suikan4github/Akashi-11/docs/Akashi-11.pdf

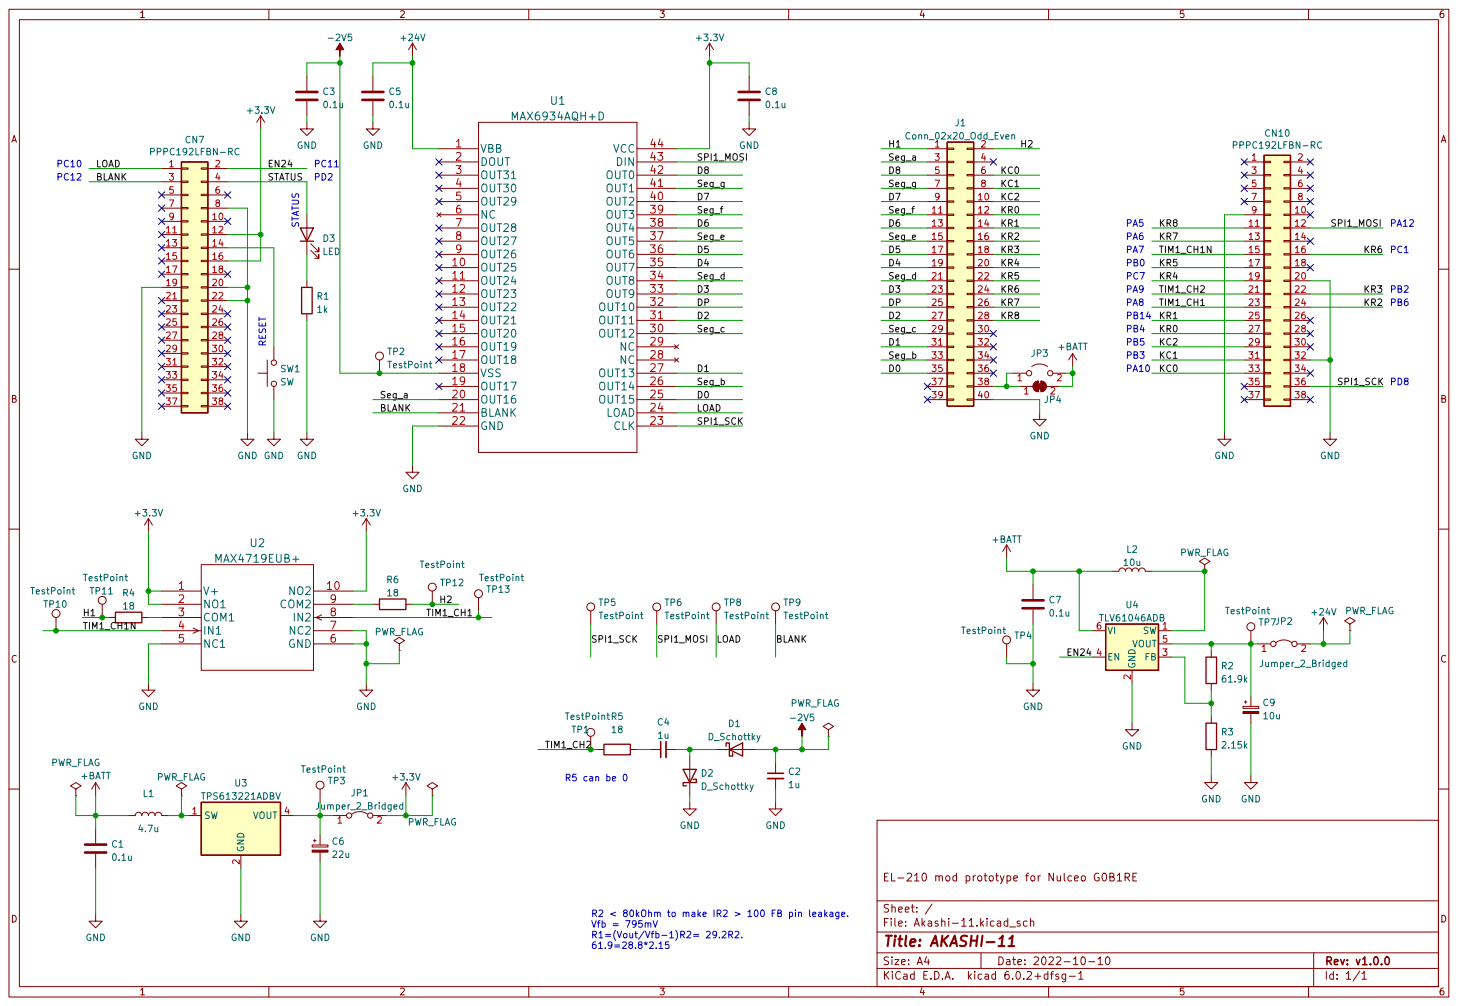
[picture p2: page 1]

2 FB 3 EN 4 VOUT 5 VI 6 U4 TLV61046ADB GND GND

File: Akashi-11.kicad_sch Sheet: / EL-210 mod prototype for Nulceo G0B1RE
