suikan4github/Akashi-11/Akashi-11.kicad_pcb

## KiCad design Akashi-11.kicad_pcb (2023-01-11)

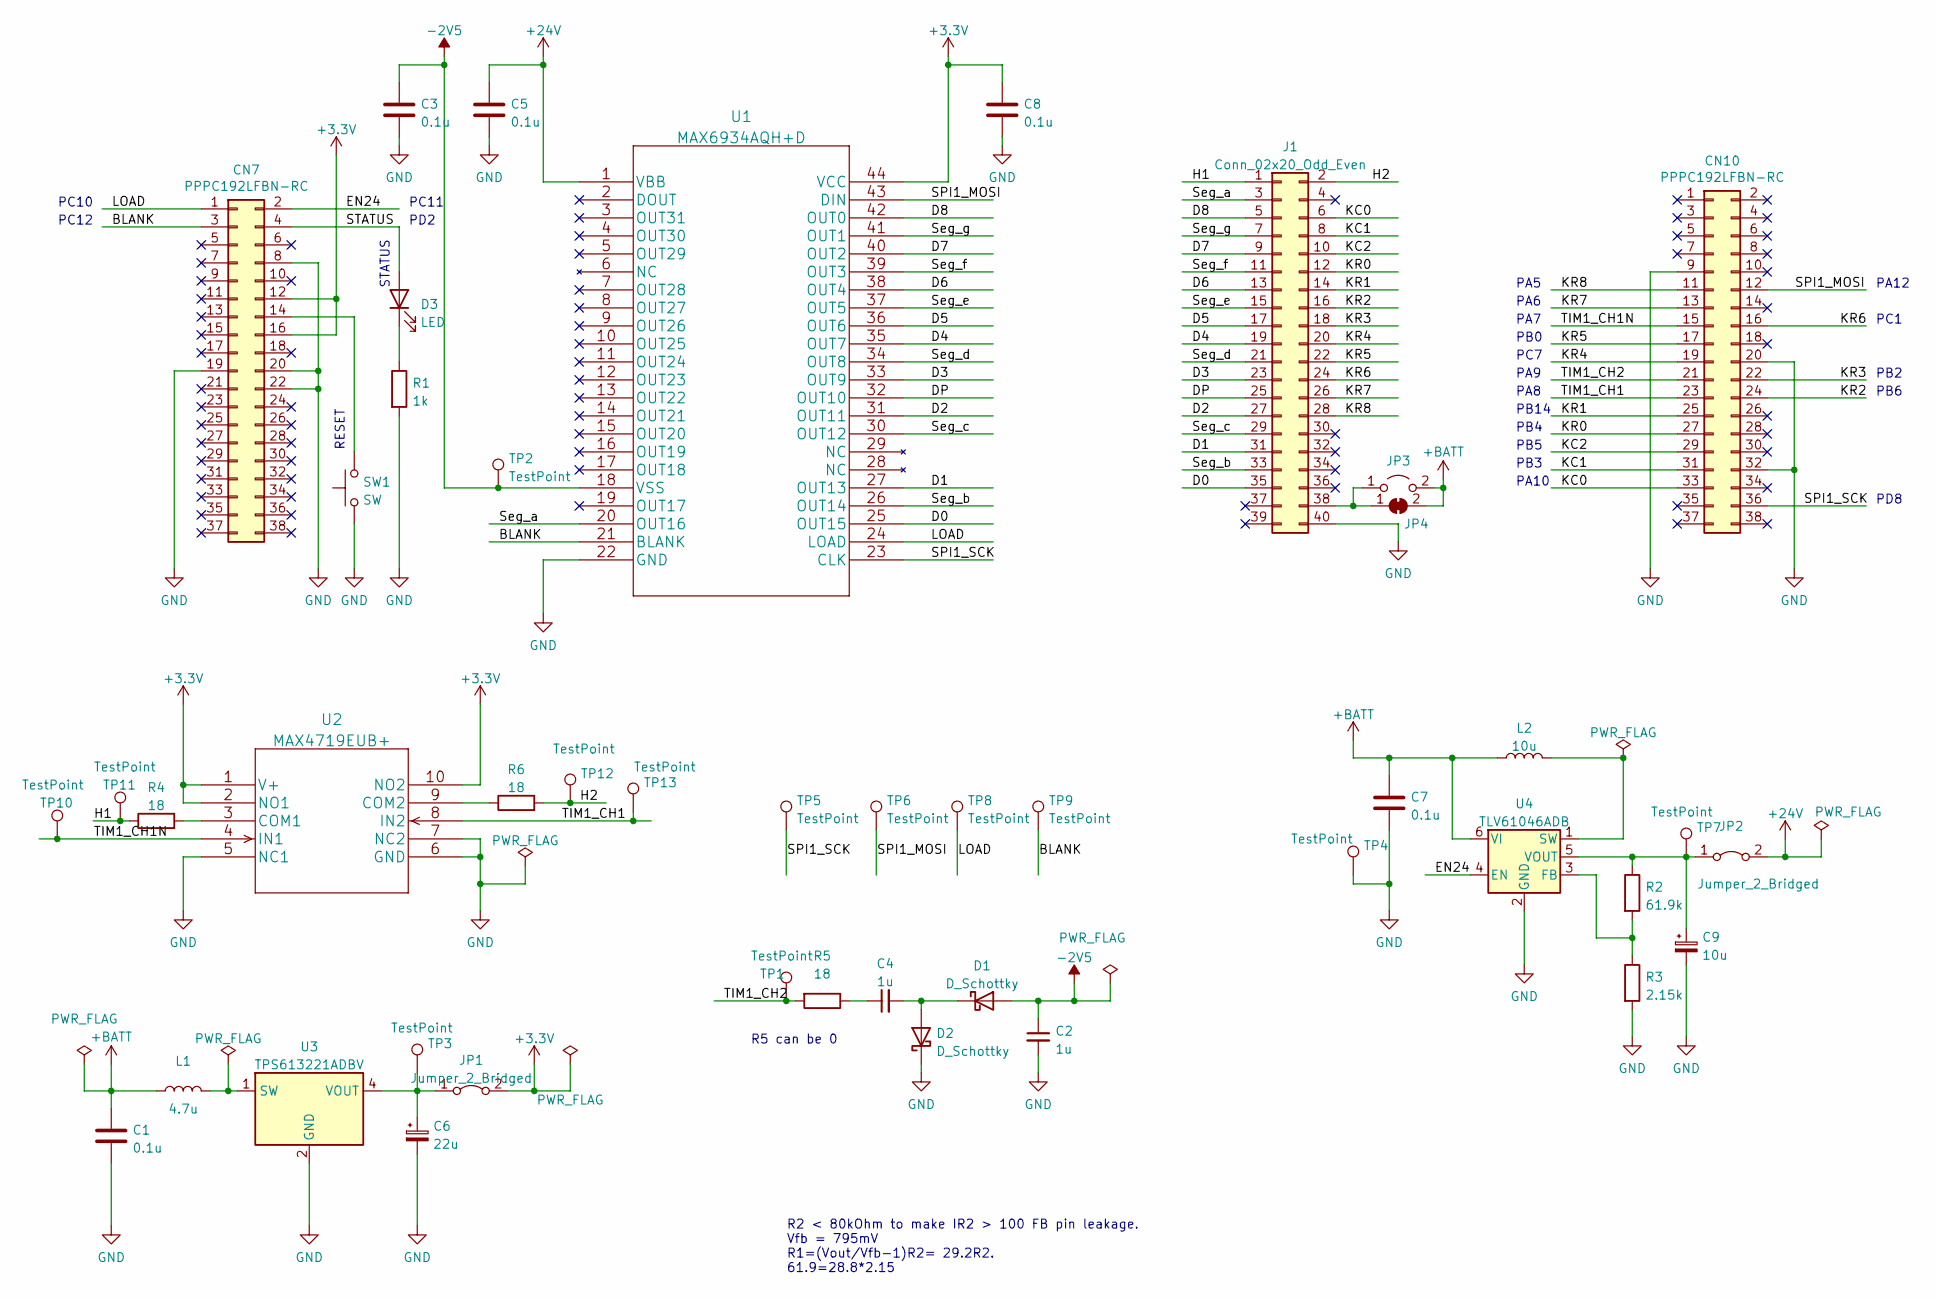
[picture p3: schematic Akashi-11.kicad_sch]

Parts:
C1, C3, C5, C7, C8: 0.1u; C_0603_1608Metric_Pad1.08x0.95mm_HandSolder
C2, C4: 1u; C_0603_1608Metric_Pad1.08x0.95mm_HandSolder
C6: 22u; CP_Elec_6.3x3
C9: 10u; CP_Elec_4x3.9
CN7, CN10: PPPC192LFBN-RC; PinSocket_2x19_P2.54mm_Vertical
D1, D2: D_Schottky; C_0603_1608Metric_Pad1.08x0.95mm_HandSolder
D3: LED; LED_D4.0mm
J1: Conn_02x20_Odd_Even; PinHeader_2x20_P2.54mm_Vertical
JP1, JP2: Jumper_2_Bridged; SolderJumper-2_P1.3mm_Bridged_RoundedPad1.0x1.5mm
JP3: Jumper_2_Open; PinHeader_1x02_P2.54mm_Vertical
JP4: SolderJumper_2_Bridged; SolderJumper-2_P1.3mm_Bridged_RoundedPad1.0x1.5mm
L1: 4.7u; LQH5BPN100M38L
L2: 10u; LQH5BPN100M38L
R1: 1k; C_0603_1608Metric_Pad1.08x0.95mm_HandSolder
R2: 61.9k; C_0603_1608Metric_Pad1.08x0.95mm_HandSolder
R3: 2.15k; C_0603_1608Metric_Pad1.08x0.95mm_HandSolder
R4, R5, R6: 18; C_0603_1608Metric_Pad1.08x0.95mm_HandSolder
SW1: SW; SW_TH_Tactile_Omron_B3F-10xx
TP1, TP2, TP3, TP4, TP5, TP6, TP7, TP8, TP9, TP10, TP11, TP12, TP13: TestPoint; TestPoint_Loop_D1.80mm_Drill1.0mm_Beaded
U1: MAX6934AQH+D; PLCC-44_THT-Socket
U2: MAX4719EUB+; MAX4719EUB
U3: TPS613221ADBV; SOT-23-5
U4: TLV61046ADB; SOT-23-6

Connections:
+3V3: C8.1, CN7.12, CN7.16, JP1.2 (B), U1.44 (VCC), U2.1 (V+), U2.2 (NO1), U2.10 (NO2)
+24V: C5.1, JP2.2 (B), U1.1 (VBB)
+BATT: C1.1, C7.1, JP3.2 (B), JP4.2 (B), L1.1, L2.1, U4.6 (VI)
-2V5: C2.1, C3.1, D1.2 (A), TP2.1, U1.18 (VSS)
/BLANK: CN7.3, TP9.1, U1.21 (BLANK)
/D0: J1.35, U1.25 (OUT15)
/D1: J1.31, U1.27 (OUT13)
/D2: J1.27, U1.31 (OUT11)
/D3: J1.23, U1.33 (OUT9)
/D4: J1.19, U1.35 (OUT7)
/D5: J1.17, U1.36 (OUT6)
/D6: J1.13, U1.38 (OUT4)
/D7: J1.9, U1.40 (OUT2)
/D8: J1.5, U1.42 (OUT0)
/DP: J1.25, U1.32 (OUT10)
/EN24: CN7.2, U4.4 (EN)
/H1: J1.1, R4.1, TP11.1
/H2: J1.2, R6.2, TP12.1
/KC0: CN10.33, J1.6
/KC1: CN10.31, J1.8
/KC2: CN10.29, J1.10
/KR0: CN10.27, J1.12
/KR1: CN10.25, J1.14
/KR2: CN10.24, J1.16
/KR3: CN10.22, J1.18
/KR4: CN10.19, J1.20
/KR5: CN10.17, J1.22
/KR6: CN10.16, J1.24
/KR7: CN10.13, J1.26
/KR8: CN10.11, J1.28
/LOAD: CN7.1, TP8.1, U1.24 (LOAD)
/SPI1_MOSI: CN10.12, TP6.1, U1.43 (DIN)
/SPI1_SCK: CN10.36, TP5.1, U1.23 (CLK)
/STATUS: CN7.4, D3.2 (A)
/Seg_a: J1.3, U1.20 (OUT16)
/Seg_b: J1.33, U1.26 (OUT14)
/Seg_c: J1.29, U1.30 (OUT12)
/Seg_d: J1.21, U1.34 (OUT8)
/Seg_e: J1.15, U1.37 (OUT5)
/Seg_f: J1.11, U1.39 (OUT3)
/Seg_g: J1.7, U1.41 (OUT1)
/TIM1_CH1: CN10.23, TP13.1, U2.8 (IN2)
/TIM1_CH1N: CN10.15, TP10.1, U2.4 (IN1)
/TIM1_CH2: CN10.21, R5.2, TP1.1
GND: C1.2, C2.2, C3.2, C5.2, C6.2, C7.2, C8.2, C9.2, CN7.8, CN7.19, CN7.20, CN7.22, CN10.9, CN10.20, CN10.32, D2.1 (K), J1.40, R1.2, R3.2, SW1.1 (A), SW1.2 (A), TP4.1, U1.22 (GND), U2.5 (NC1), U2.6 (GND), U2.7 (NC2), U3.2 (GND), U4.2 (GND)
unnamed: C4.1, R5.1
unnamed: C4.2, D1.1 (K), D2.2 (A)
unnamed: C6.1, JP1.1 (A), TP3.1, U3.4 (VOUT)
unnamed: C9.1, JP2.1 (A), R2.1, TP7.1, U4.5 (VOUT)
unnamed: CN7.14, SW1.3 (B), SW1.4 (B)
unnamed: D3.1 (K), R1.1
unnamed: J1.38, JP3.1 (A), JP4.1 (A)
unnamed: L1.2, U3.1 (SW)
unnamed: L2.2, U4.1 (SW)
unnamed: R2.2, R3.1, U4.3 (FB)
unnamed: R4.2, U2.3 (COM1)
unnamed: R6.1, U2.9 (COM2)

Notes on the sheet:
PB6
PD8
RESET
PA9
STATUS
R5 can be 0
PC1
PB2
R2 < 80kOhm to make IR2 > 100 FB pin leakage. Vfb = 795mV R1=(Vout/Vfb-1)R2= 29.2R2. 61.9=28.8*2.15
PC10
PA5
PB4
PB5
PB14
PA6
PB3
PC11
PC12
PB0
PD2
PA10
PA8
PC7
PA12
PA7

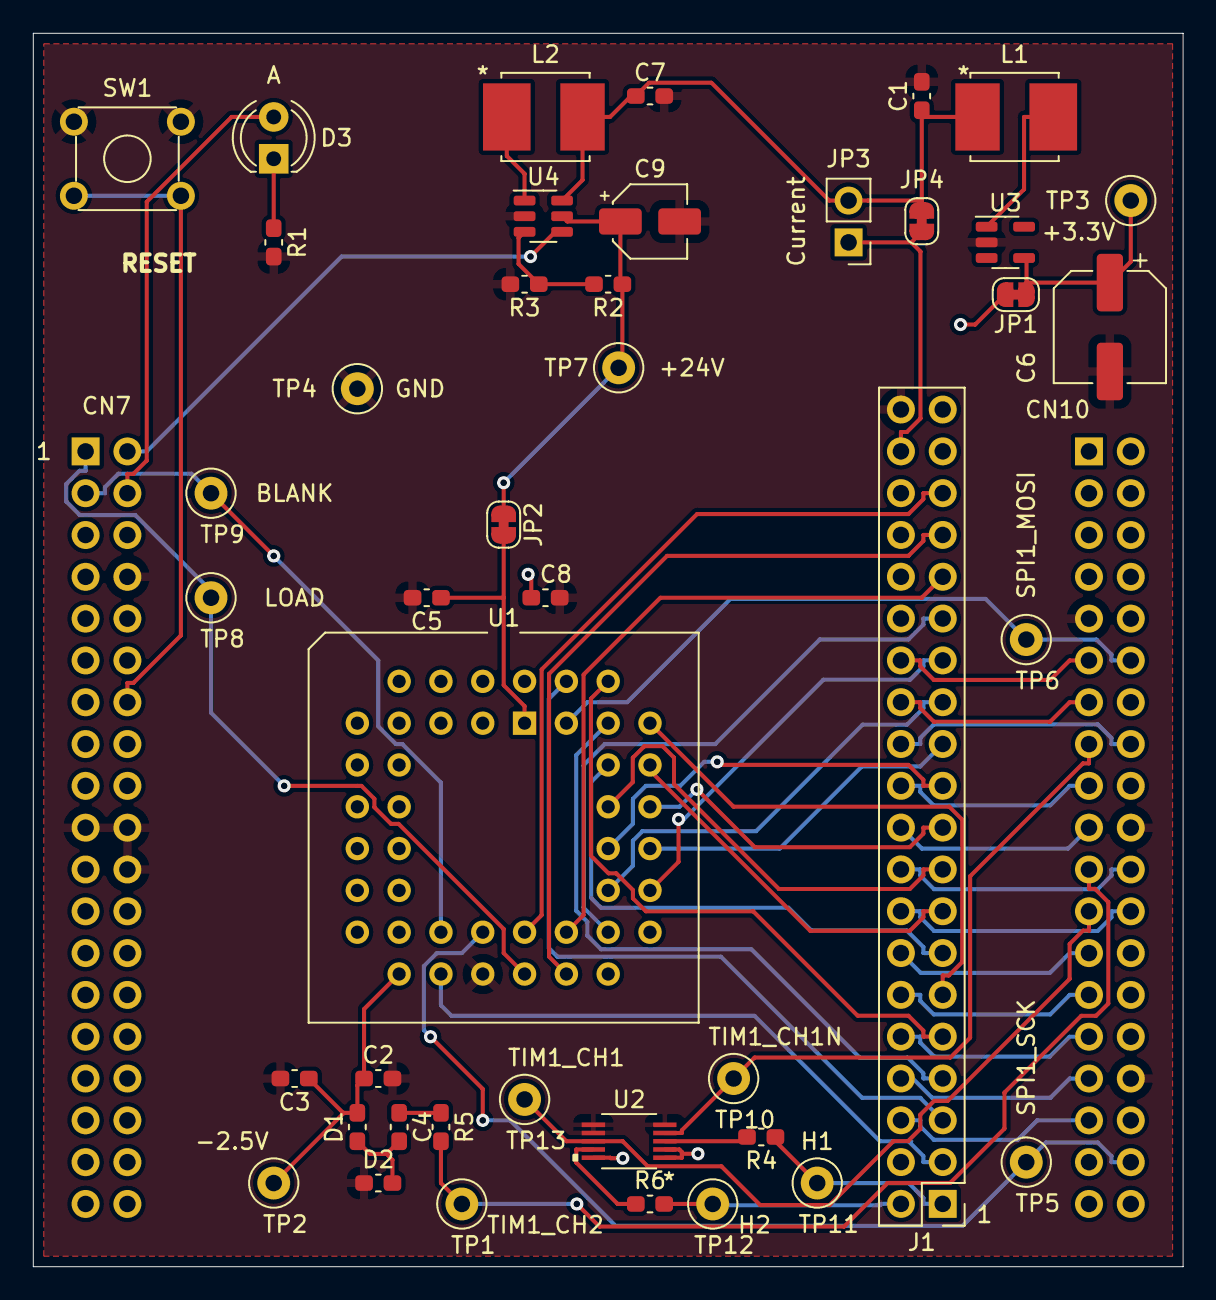
[picture p4: board Akashi-11.kicad_pcb from above]

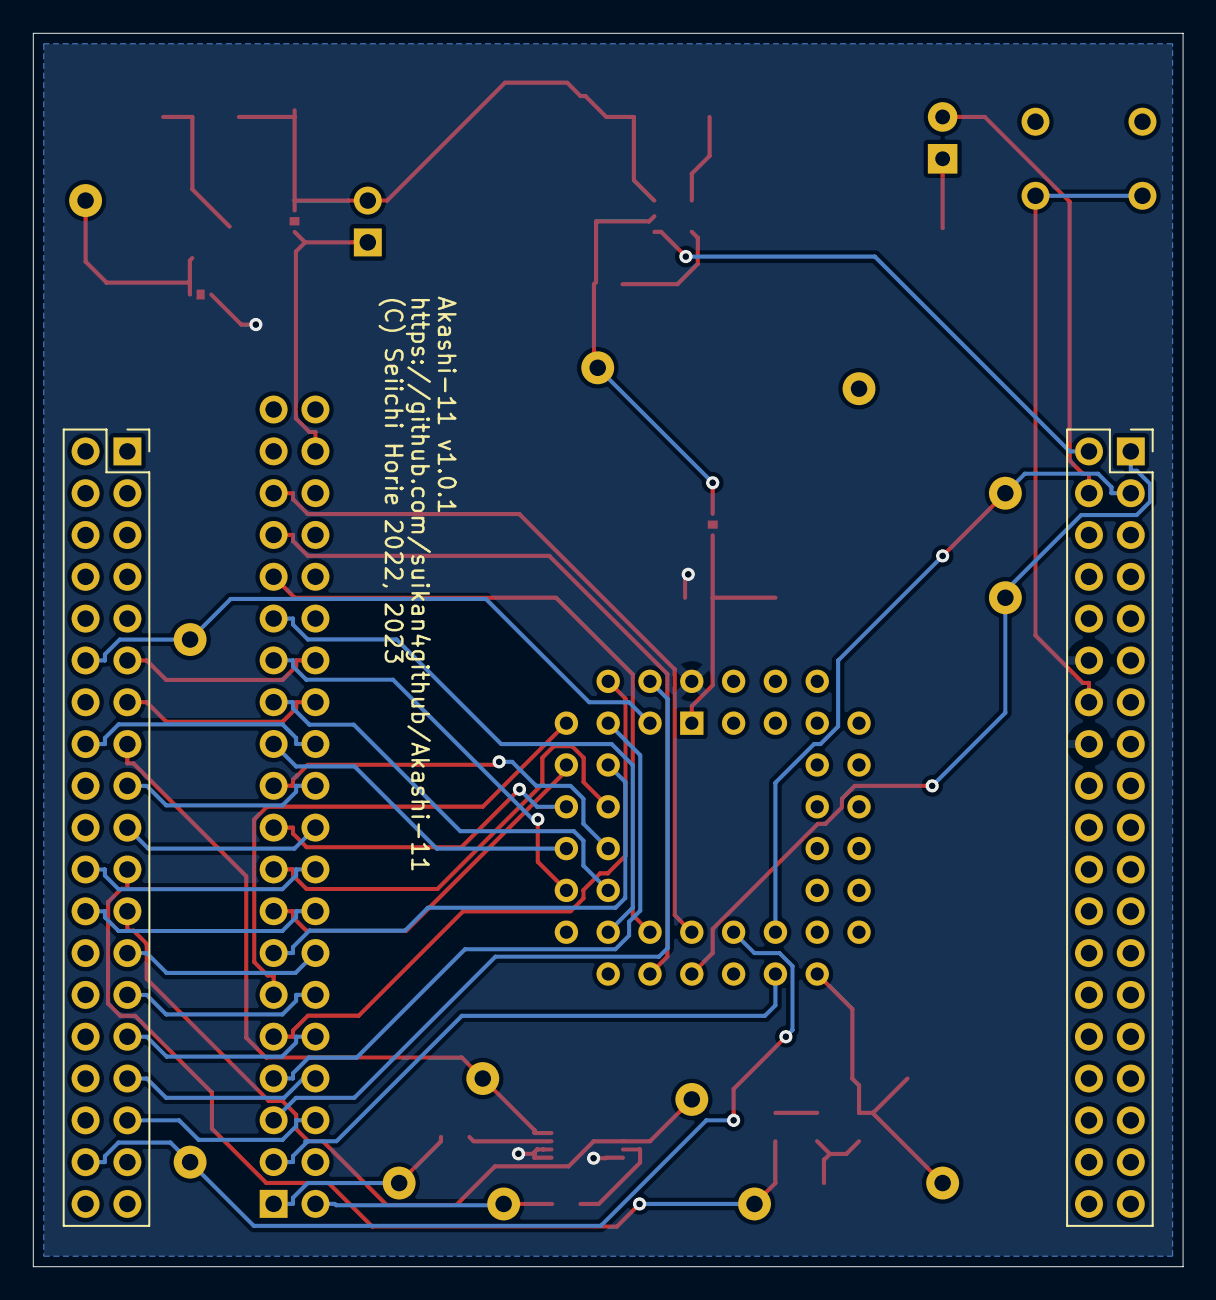
[picture p5: board Akashi-11.kicad_pcb from below]

Board: 2 copper layers, 69.9 x 74.9 mm, 45 parts (2 on the bottom side), 57 nets.
