suikan4github/Akashi-11/CHANGELOG.md

# Change log
Record of the modification in project development.
## [Unreleased] yyyy-mm-dd

### Added
### Changed
### Deprecated
### Removed
### Fixed
### Security
### Known Issue

[Unreleased]: https://github.com/suikan4github/Akashi-04/compare/v0.0.0...develop
