suikan4github/Akashi-11/(commit log)

2022-10-10 Place empty schematics and board design.
    [Akashi-11.kicad_pcb, Akashi-11.kicad_sch]
2022-10-23 Rough schematics drawing.
    [Akashi-11.kicad_sch]
2022-10-23 Add bypass capacitor to -2.5V of the VFD driver.
    Schematics layout is refined.
    [Akashi-11.kicad_sch]
2022-11-06 ERC finished
    [Akashi-11.kicad_sch]
2022-11-06 Initial layout of PCB.
    [Akashi-11.kicad_pcb, Akashi-11.kicad_sch]
2022-11-12 Routing finished
    [Akashi-11.kicad_pcb, Akashi-11.kicad_sch]
2022-11-12 Add EN24 signal and description of README
    [Akashi-11.kicad_pcb, Akashi-11.kicad_sch]
2022-11-14 Layout of schematics is refined.
    Added schematics PDF.
    [Akashi-11.kicad_sch]
2022-11-23 Layout refined.
    Footprint of L is updated for hand soldering.
    Electric Capacitor foot print is now same with EL-210-MOD.
    Heater resiters are now same withe EL-210-MOD.
    [Akashi-11.kicad_pcb, Akashi-11.kicad_sch]
2022-11-27 Add current measurment point
    [Akashi-11.kicad_pcb, Akashi-11.kicad_sch]
2022-11-27 Add PDF schematics.
2022-12-03 Changed from Nucleo to RPi Pico
    [Akashi-11.kicad_pcb, Akashi-11.kicad_sch]
2022-12-10 Revert "Changed from Nucleo to RPi Pico"
    This reverts commit 16e9e4a1a83ee259be72a8795d021f70ac3e2adc.
    [Akashi-11.kicad_pcb, Akashi-11.kicad_sch]
2022-12-11 Gerber file generated
    [Akashi-11-B_Cu.gbl, Akashi-11-B_Mask.gbs, Akashi-11-B_Silkscreen.gbo, Akashi-11-Edge_Cuts.gm1, Akashi-11-F_Cu.gtl, Akashi-11-F_Mask.gts, Akashi-11-F_Silkscreen.gto, Akashi-11-NPTH.drl]
2023-01-09 Change signal name from TIM2_CH1 to TIM1_CH2
    Fixed typo. The layout is not changed.
    The sylkscreen of the singal is still wrong.
    [Akashi-11.kicad_pcb, Akashi-11.kicad_sch]
2023-01-11 Modified schematics and silk.
    - KEY matrix signal name is changed.
    -- Including bug fix of the row order.
    - R5 is changed to small resiter to fix the to small voltage.
    Gerber re-generated. Schematics re-generated in PDF.
    [Akashi-11-B_Cu.gbl, Akashi-11-B_Mask.gbs, Akashi-11-B_Silkscreen.gbo, Akashi-11-Edge_Cuts.gm1, Akashi-11-F_Cu.gtl, Akashi-11-F_Mask.gts, Akashi-11-F_Silkscreen.gto, Akashi-11-NPTH.drl]
